aleghezzo/audiopoweramplifier/Latex/graficos-tp1/Corriente.png

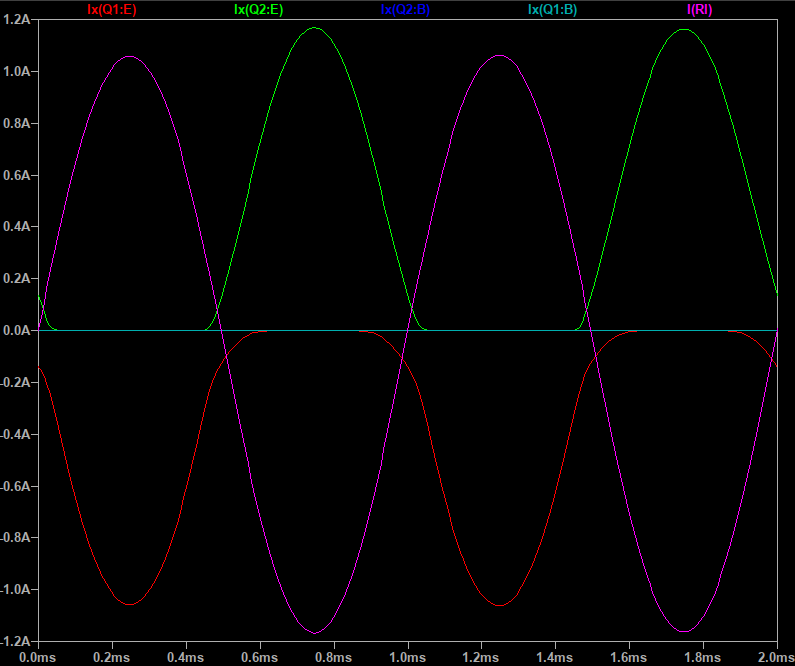
Latex/graficos-tp1/Corriente.png
