aleghezzo/audiopoweramplifier/Latex/graficos-tp1/Dinamico.png

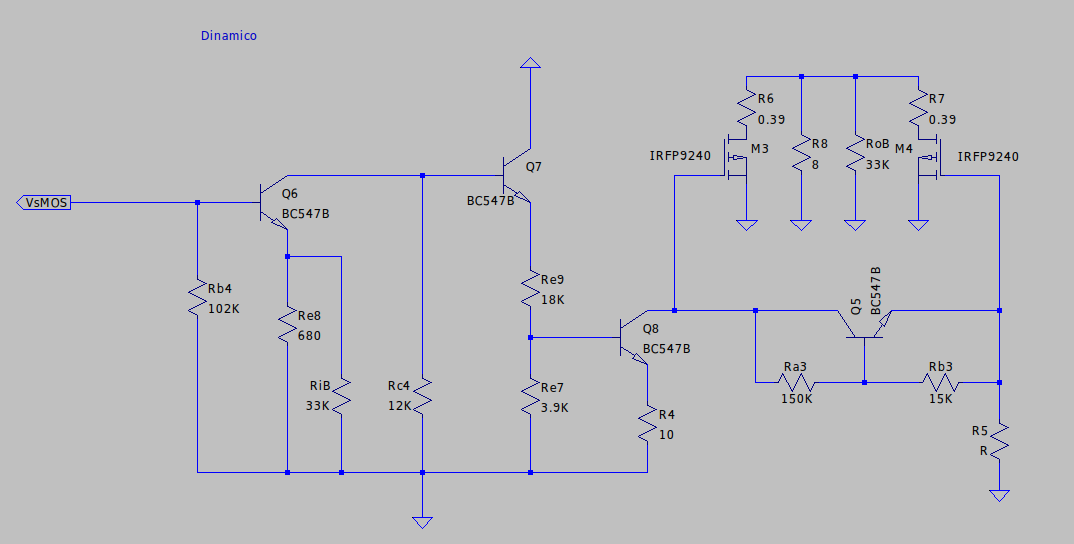
Latex/graficos-tp1/Dinamico.png
