aleghezzo/audiopoweramplifier/Latex/graficos-tp1/DisenoFinalUlt2.png

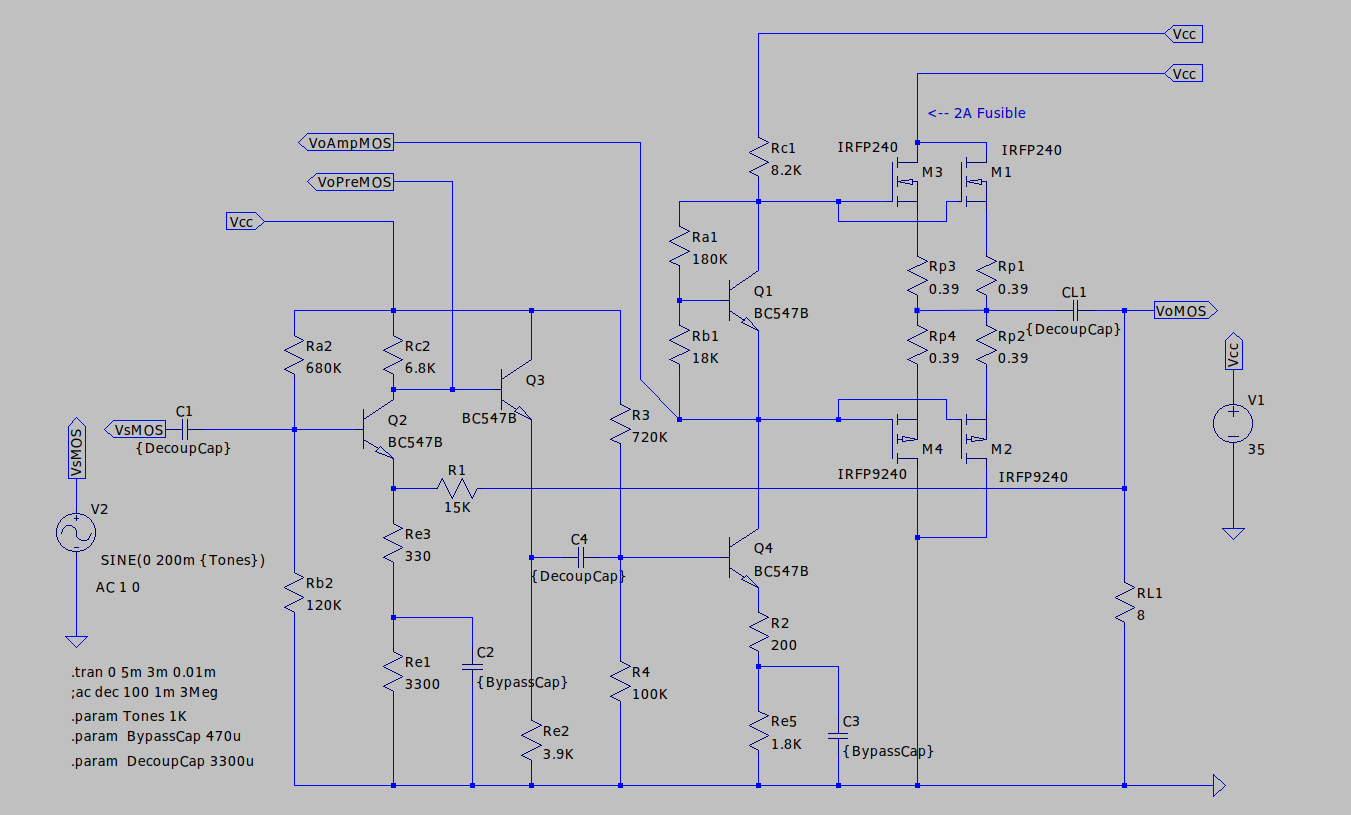
Latex/graficos-tp1/DisenoFinalUlt2.png
