aleghezzo/audiopoweramplifier/Latex/graficos-tp1/EtapaAmplificadoraTBJ.png

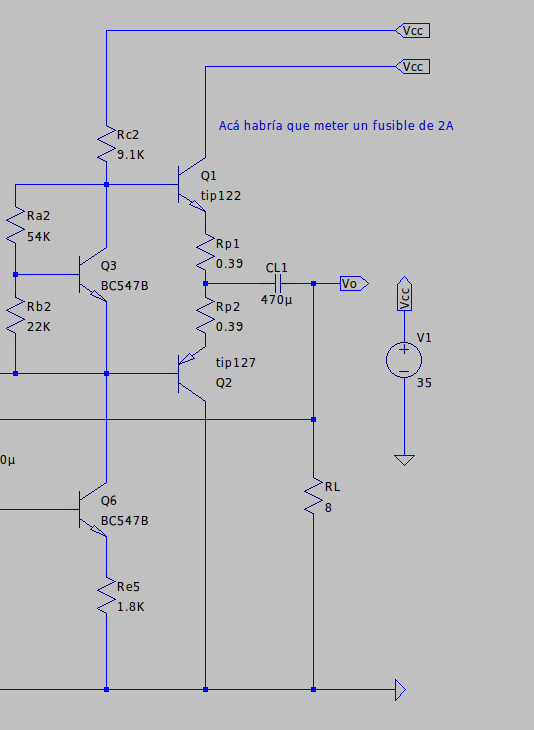
Latex/graficos-tp1/EtapaAmplificadoraTBJ.png
