aleghezzo/audiopoweramplifier/Latex/graficos-tp1/EtapaEntradaTBJ.png

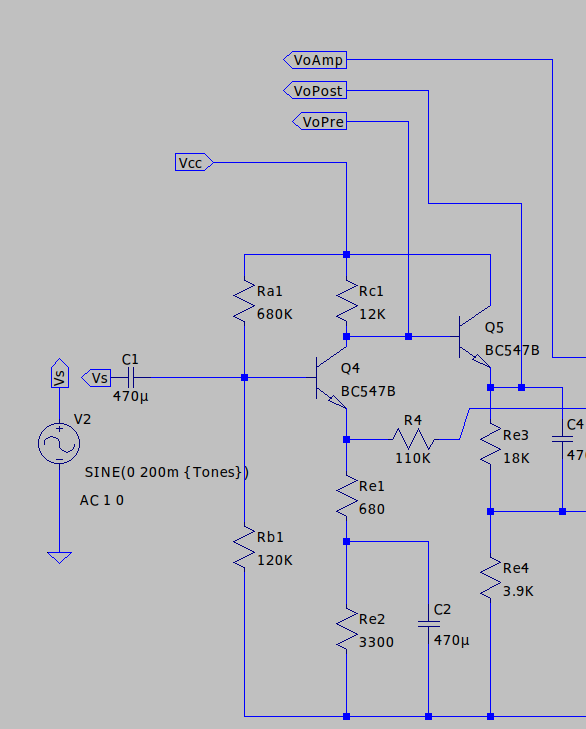
Latex/graficos-tp1/EtapaEntradaTBJ.png
