aleghezzo/audiopoweramplifier/Latex/graficos-tp1/FalsoPNP.png

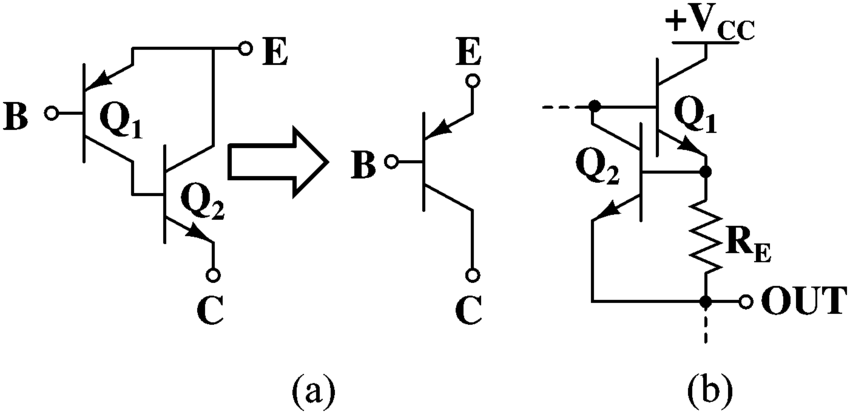
Latex/graficos-tp1/FalsoPNP.png
