aleghezzo/audiopoweramplifier/Latex/graficos-tp1/Potencia.png

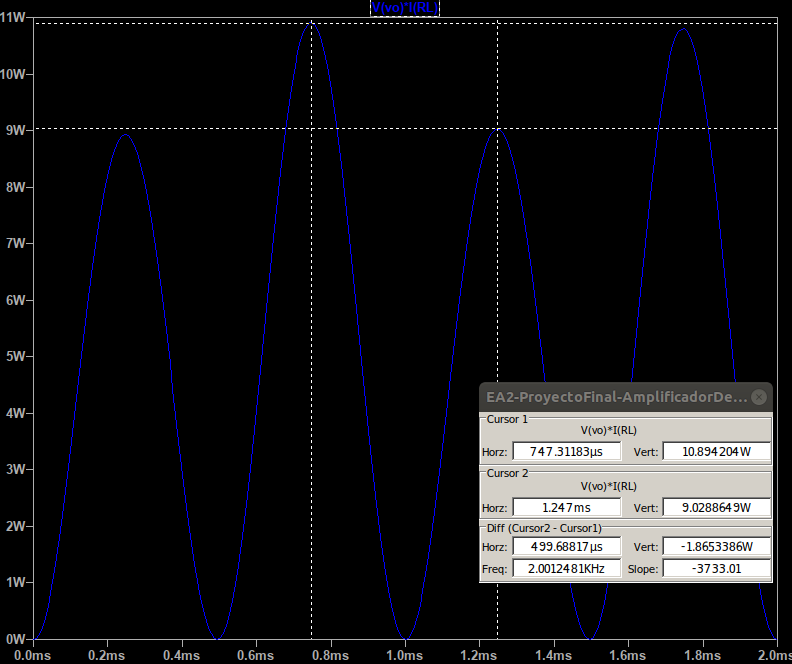
Latex/graficos-tp1/Potencia.png
