aleghezzo/audiopoweramplifier/Latex/graficos-tp1/Vo.png

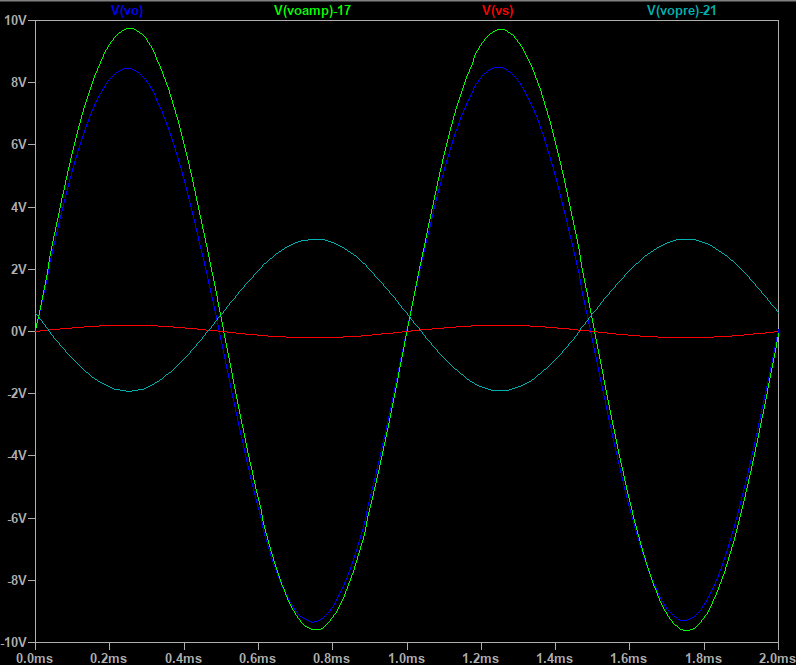
Latex/graficos-tp1/Vo.png
