aleghezzo/audiopoweramplifier/Latex/graficos-tp1/VoAmp.png

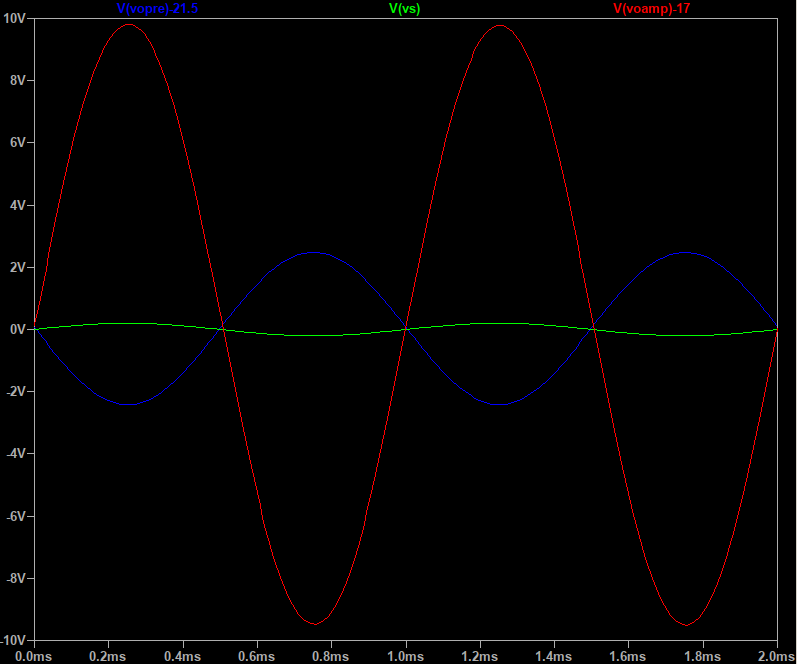
Latex/graficos-tp1/VoAmp.png
