aleghezzo/audiopoweramplifier/Latex/kicad/audioamplifier.pdf

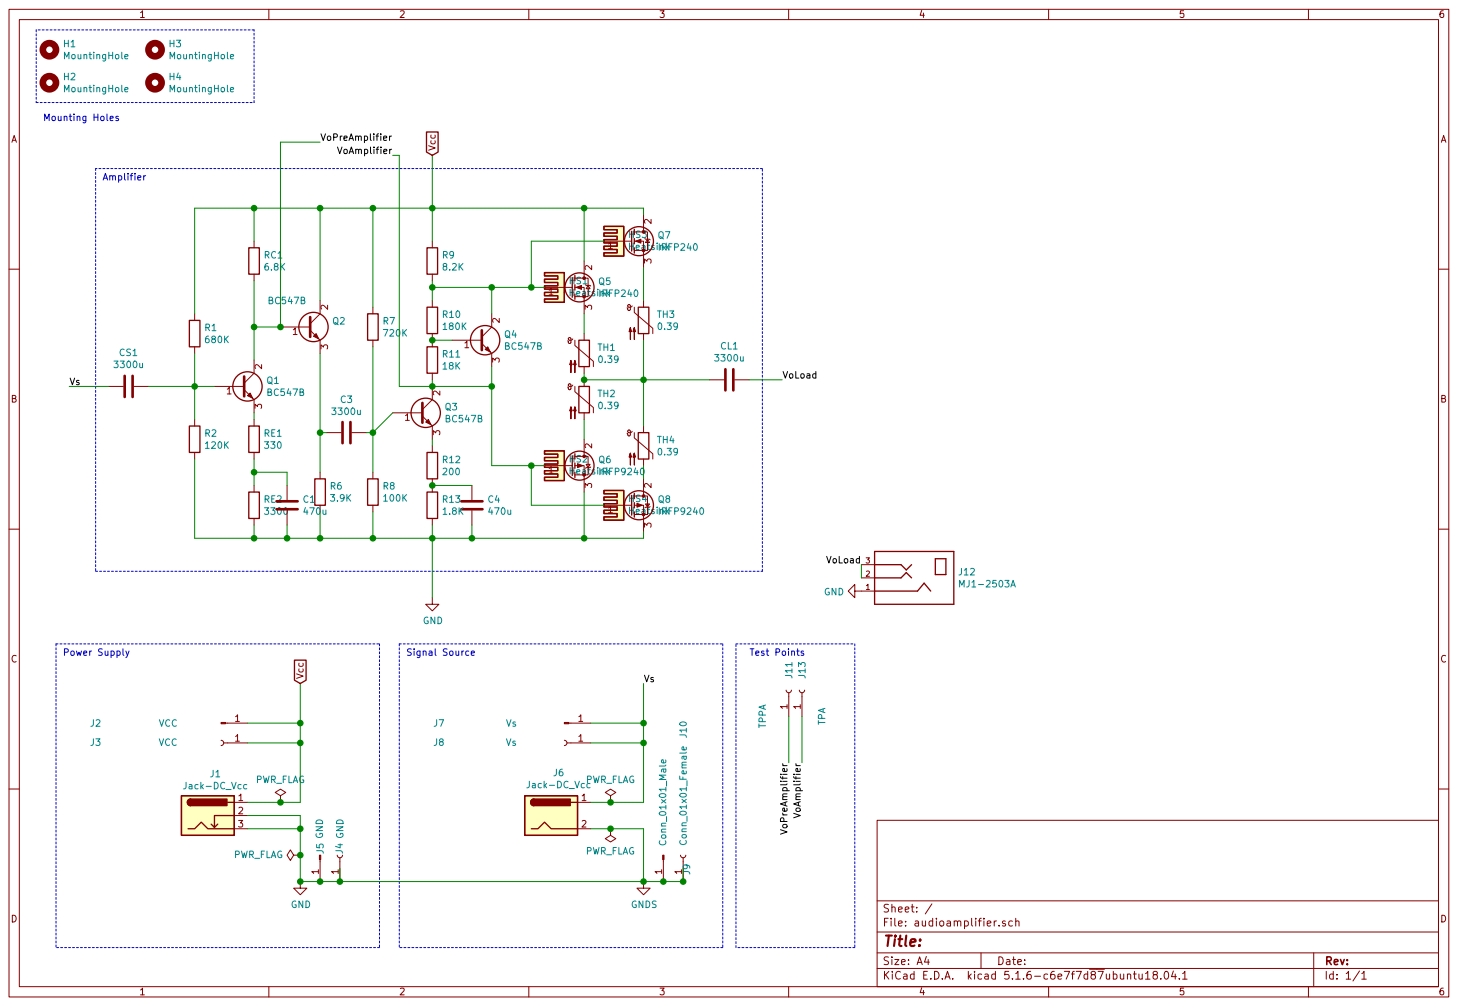
[picture p47: page 1]

HS4 Heatsink HS3 Heatsink HS2 Heatsink HS1 Heatsink

File: audioamplifier.sch Sheet: /
Id: 1/1 Title:
