aleghezzo/audiopoweramplifier/Latex/kicad/audioamplifier-B_Cu.pdf

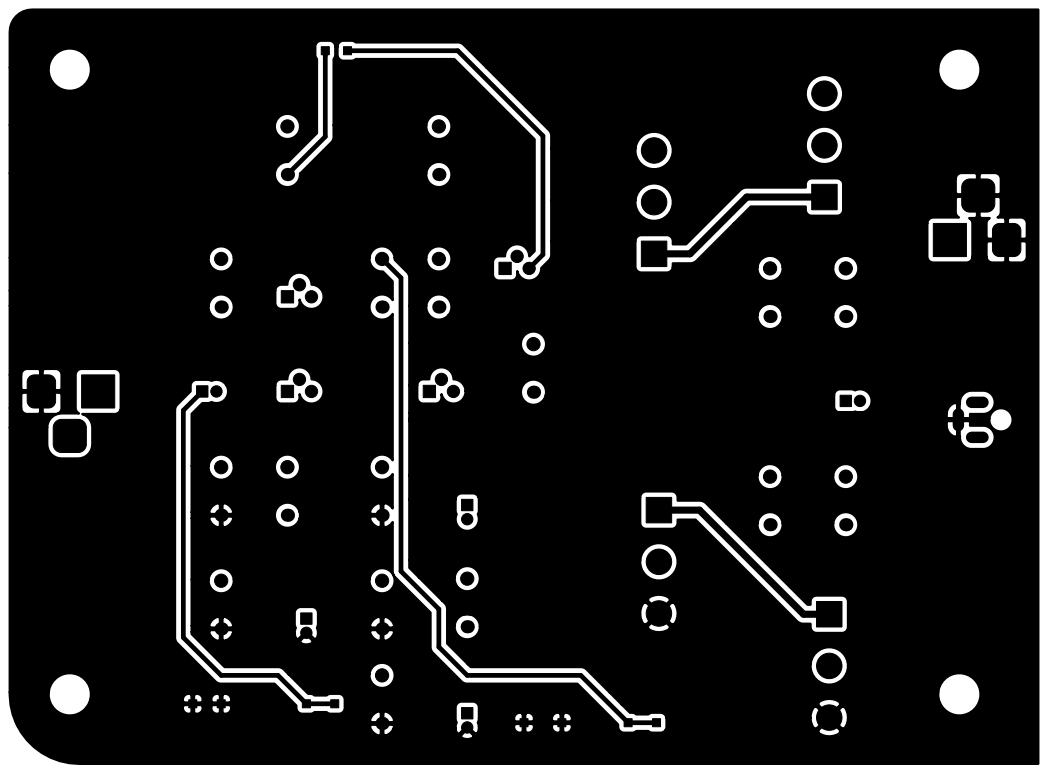
[picture p48: page 1]
