aleghezzo/audiopoweramplifier/Latex/kicad/audioamplifier-B_Mask.pdf

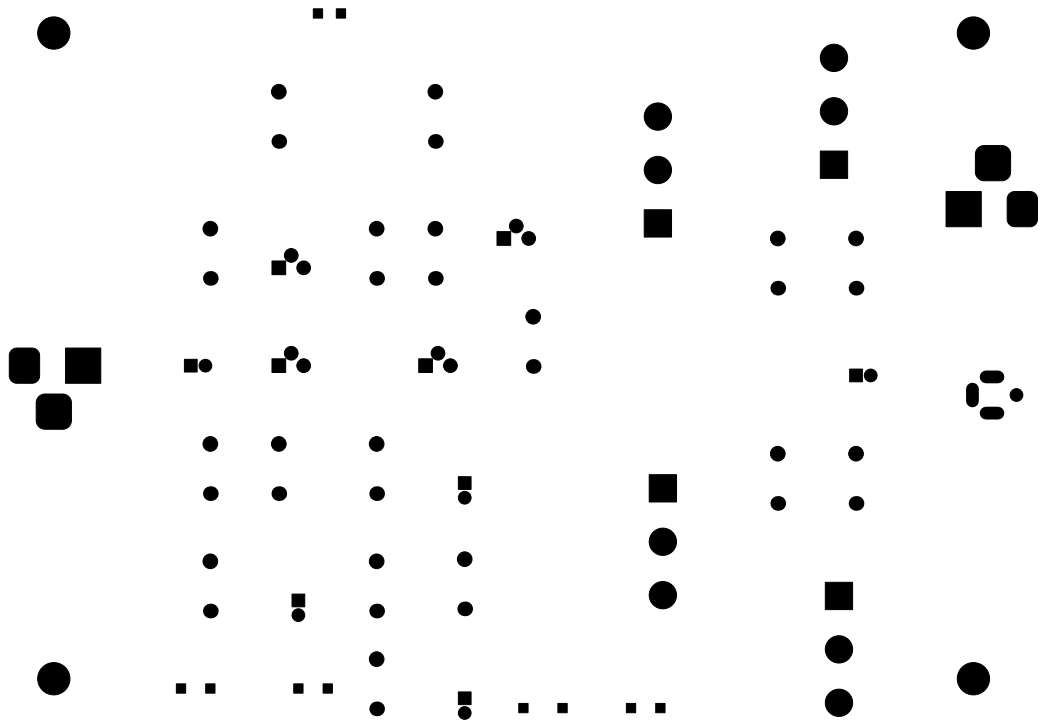
[picture p49: page 1]
