aleghezzo/audiopoweramplifier/Latex/kicad/audioamplifier-Edge_Cuts.pdf

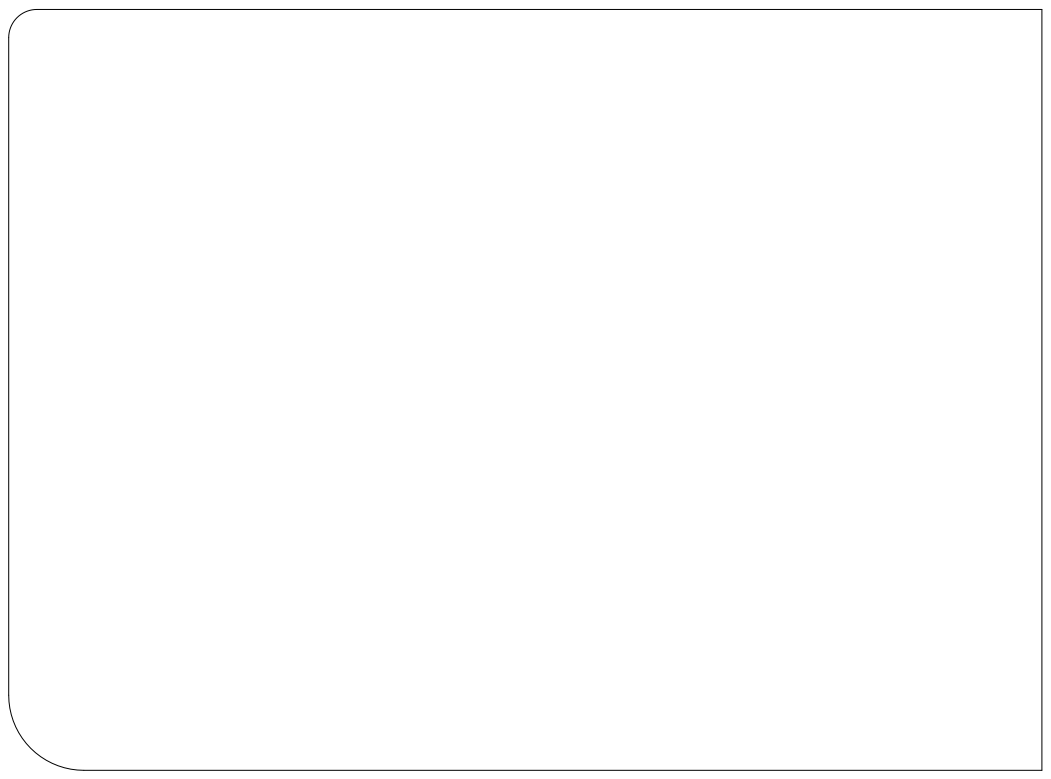
[picture p50: page 1]
