aleghezzo/audiopoweramplifier/Latex/kicad/audioamplifier-F_Cu.pdf

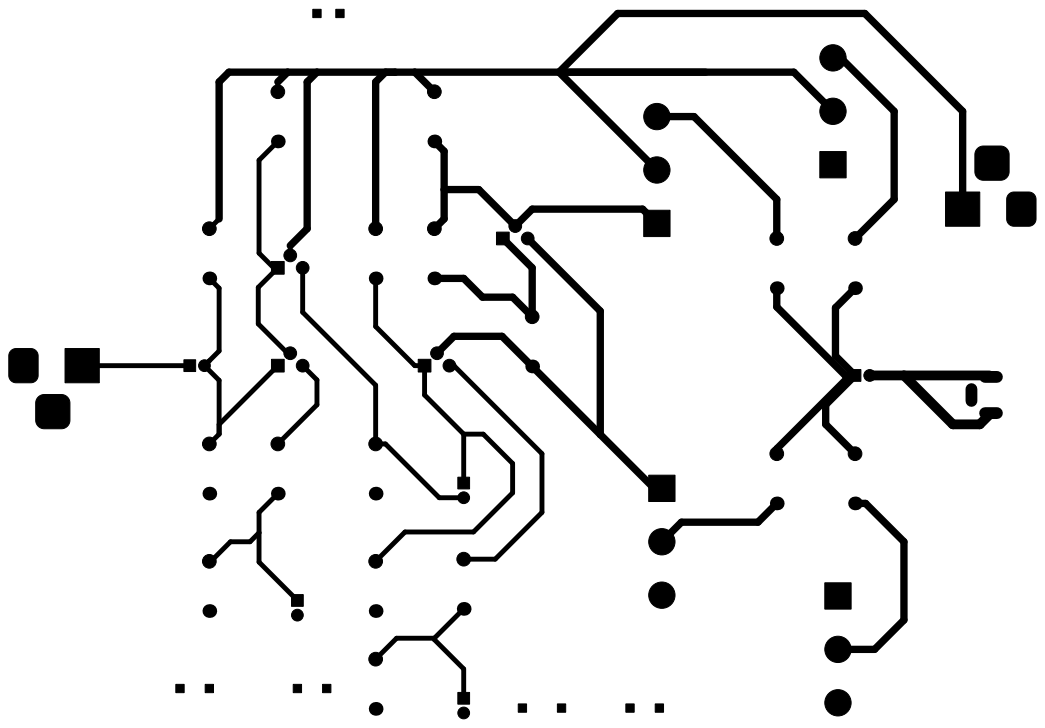
[picture p51: page 1]
