aleghezzo/audiopoweramplifier/Latex/kicad/audioamplifier-F_SilkS.pdf

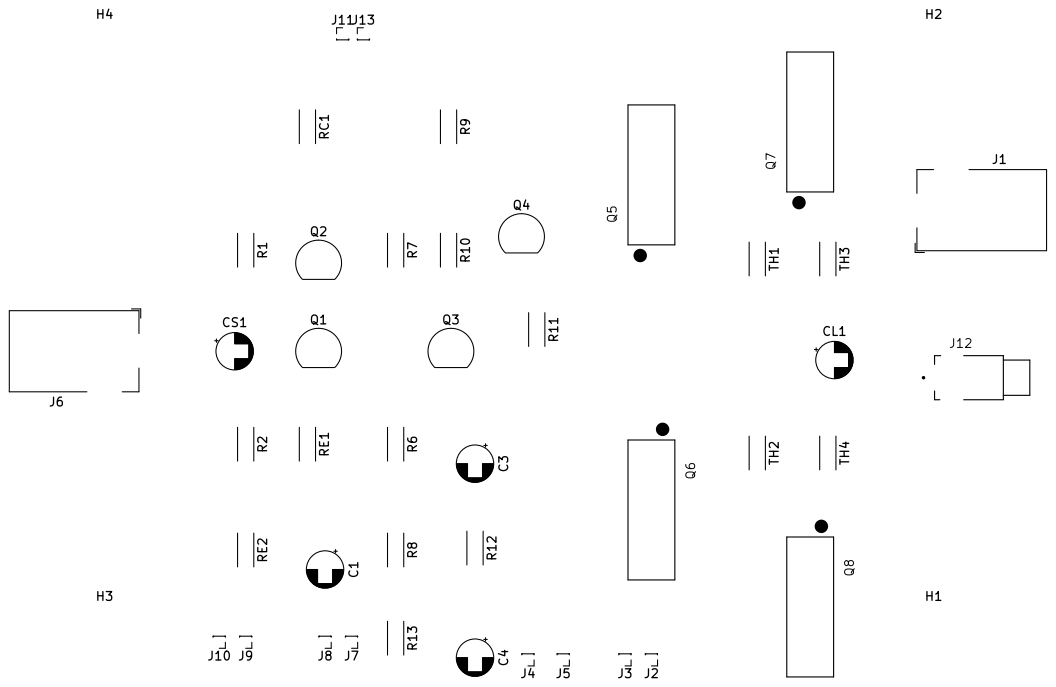
[picture p52: page 1]
