aleghezzo/audiopoweramplifier/Simulación/EA2-ProyectoFinal-AmplificadorDeBajaPotencia_MOS_Only_27-12-2020.asc

C1: cap; {DecoupCap}
C2: cap; {BypassCap}
C3: cap; {BypassCap}
C4: cap; {DecoupCap}
CL1: cap; {DecoupCap}
M1: nmos; IRFP240
M2: pmos; IRFP9240
M3: nmos; IRFP240
M4: pmos; IRFP9240
Q1: npn; BC547B
Q2: npn; BC547B
Q3: npn; BC547B
Q4: npn; BC547B
R1: res; 15K
R2: res; 200
R3: res; 720K
R4: res; 100K
Ra1: res; 180K
Ra2: res; 680K
Rb1: res; 18K
Rb2: res; 120K
Rc1: res; 8.2K
Rc2: res; 6.8K
Re1: res; 3300
Re2: res; 3.9K
Re3: res; 330
Re5: res; 1.8K
RL1: res; 8
Rp1: res; 0.39
Rp2: res; 0.39
Rp3: res; 0.39
Rp4: res; 0.39
V1: voltage; 35
V2: signal; SINE(0 200m {Tones}); AC 1 0
Named nets: 0, Vcc, VoMOS, VoPreMOS, VsMOS, VoAmpMOS
.tran 0 100m 3m 0.01m
;ac dec 100 1m 3Meg
.param Tones 20
<-- 2A Fusible
.param  BypassCap 470u
.param  DecoupCap 3300u
