aleghezzo/audiopoweramplifier/Simulación/EA2-ProyectoFinal-AmplificadorDeBajaPotencia_TBJ_Only.asc

C2: cap; {BypassCap}
C3: cap; {BypassCap}
C4: cap; {DecoupCap}
C5: cap; {DecoupCap}
CL1: cap; {DecoupCap}
Q1: npn; tip122
Q2: pnp; tip127
Q3: npn; BC547B
Q4: npn; BC547B
Q5: npn; BC547B
Q6: npn; BC547B
Q7: npn; tip122
Q8: pnp; tip127
R1: res; 15K
R2: res; 10
R3: res; 720K
R4: res; 100K
Ra1: res; 64K
Ra2: res; 680K
Rb1: res; 33K
Rb2: res; 120K
Rc1: res; 8.2K
Rc2: res; 6.8K
Re1: res; 3300
Re2: res; 3.9K
Re3: res; 330
Re4: res; 1.8K
RL: res; 8
Rp1: res; 0.39
Rp2: res; 0.39
Rp3: res; 0.39
Rp4: res; 0.39
V1: voltage; 35
V5: signal; SINE(0 200m {Tones}); AC 1 0
Named nets: Vcc, Vo, 0, VsTBJ, VoPreMOS, VoAmpMOS
.INCLUDE "C:\\Program Files\\LTC\\LTspiceXVII\\lib\\sub\\TIP122.LIB"
.INCLUDE "C:\\Program Files\\LTC\\LTspiceXVII\\lib\\sub\\TIP127.LIB"
<-- Fusible 2 A
.tran 0 1 0.5 0.01m
;ac dec 100 1m 3Meg
.param Tones 20
.param  BypassCap 470u
.param  DecoupCap 3300u
