aleghezzo/audiopoweramplifier/KiCAD/audioamplifier/audioamplifier.kicad_pcb

## KiCad design KiCAD/audioamplifier/audioamplifier.kicad_pcb (2021-01-25)

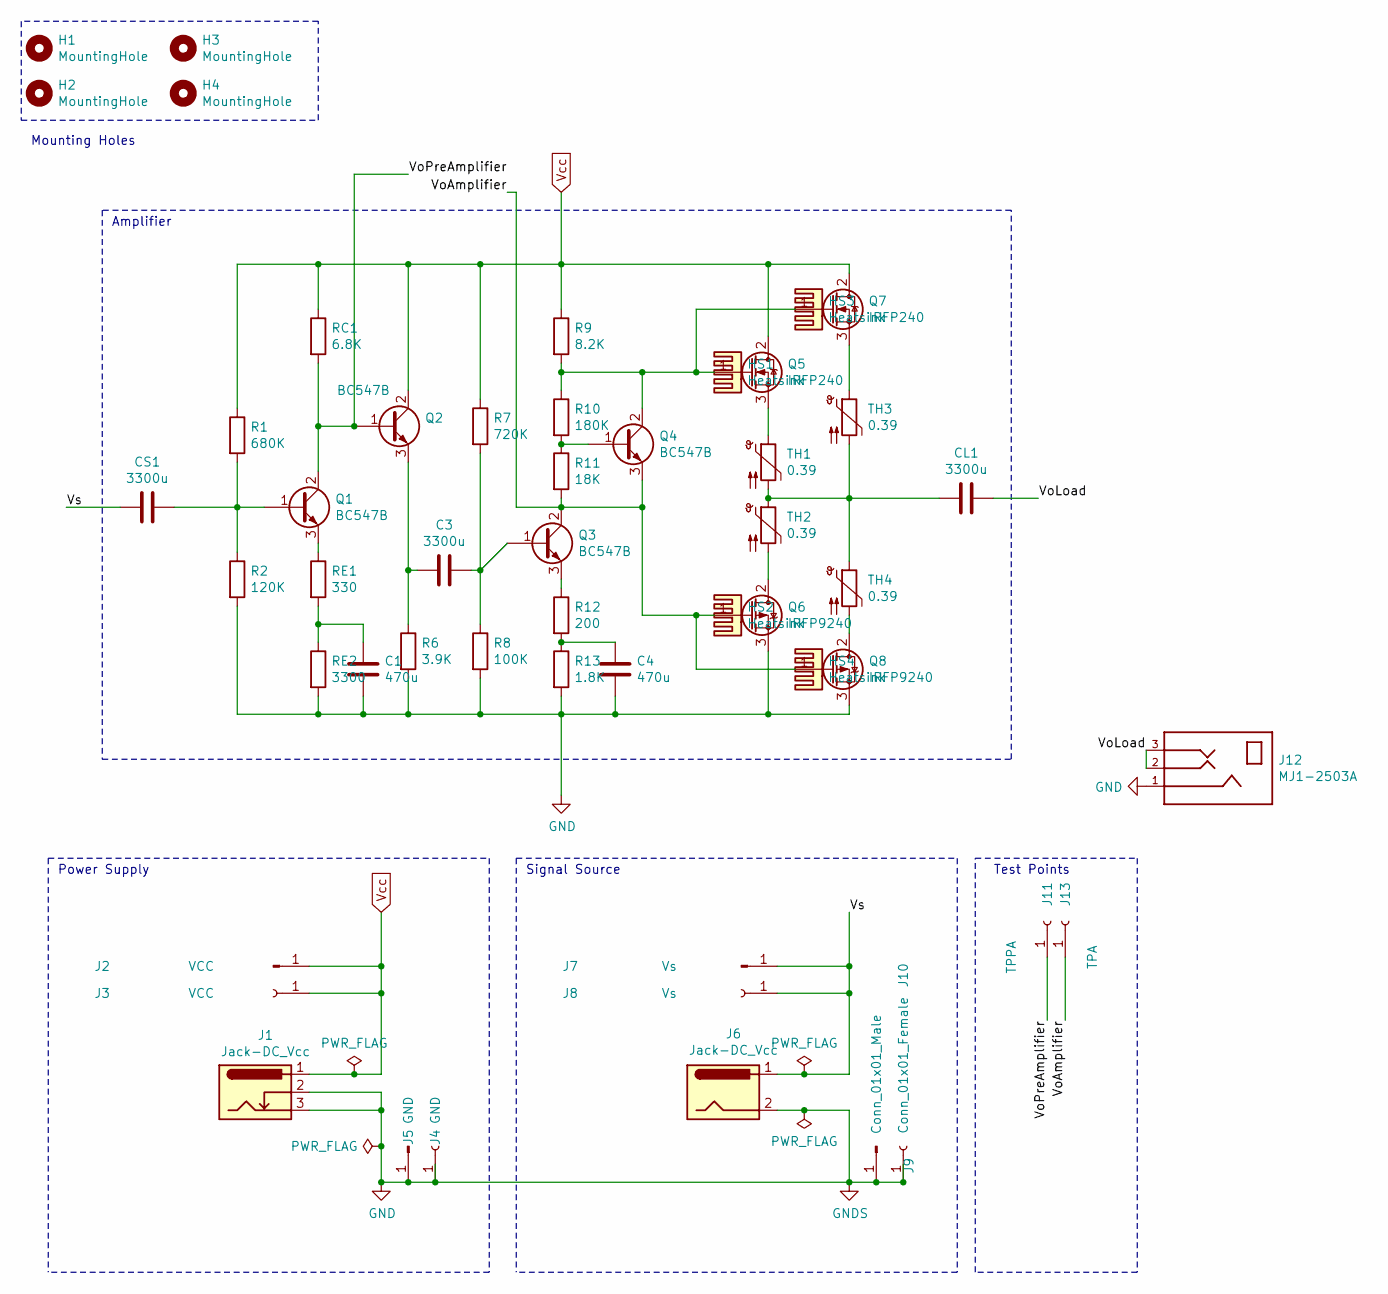
[picture p53: schematic audioamplifier.sch]

Parts:
C1, C4: 470u; CP_Radial_D4.0mm_P1.50mm
C3: 3300u; CP_Radial_D4.0mm_P1.50mm
CL1: 3300u; CP_Radial_D4.0mm_P1.50mm
CS1: 3300u; CP_Radial_D4.0mm_P1.50mm
H1, H2, H3, H4: MountingHole; MountingHole_3.2mm_M3
HS1, HS2, HS3, HS4: Heatsink; Heatsink_Stonecold_HS-132_32x14mm_2xFixation1.5mm
J1, J6: Jack-DC_Vcc; BarrelJack_Horizontal
J2, J3: VCC; PinHeader_1x01_P1.00mm_Vertical
J4, J5: GND; PinHeader_1x01_P1.00mm_Vertical
J7, J8: Vs; PinHeader_1x01_P1.00mm_Vertical
J9: Conn_01x01_Male; PinHeader_1x01_P1.00mm_Vertical
J10: Conn_01x01_Female; PinHeader_1x01_P1.00mm_Vertical
J11: TPPA; PinHeader_1x01_P1.00mm_Vertical
J12: MJ1-2503A; CUI_MJ1-2503A; PART_REV A
J13: TPA; PinHeader_1x01_P1.00mm_Vertical
Q1, Q2, Q3, Q4: BC547B; TO-92
Q5, Q7: IRFP240; TO247AC
Q6, Q8: IRFP9240; TO247AC
R1: 680K; R_Axial_DIN0204_L3.6mm_D1.6mm_P5.08mm_Horizontal
R2: 120K; R_Axial_DIN0204_L3.6mm_D1.6mm_P5.08mm_Horizontal
R6: 3.9K; R_Axial_DIN0204_L3.6mm_D1.6mm_P5.08mm_Horizontal
R7: 720K; R_Axial_DIN0204_L3.6mm_D1.6mm_P5.08mm_Horizontal
R8: 100K; R_Axial_DIN0204_L3.6mm_D1.6mm_P5.08mm_Horizontal
R9: 8.2K; R_Axial_DIN0204_L3.6mm_D1.6mm_P5.08mm_Horizontal
R10: 180K; R_Axial_DIN0204_L3.6mm_D1.6mm_P5.08mm_Horizontal
R11: 18K; R_Axial_DIN0204_L3.6mm_D1.6mm_P5.08mm_Horizontal
R12: 200; R_Axial_DIN0204_L3.6mm_D1.6mm_P5.08mm_Horizontal
R13: 1.8K; R_Axial_DIN0204_L3.6mm_D1.6mm_P5.08mm_Horizontal
RC1: 6.8K; R_Axial_DIN0204_L3.6mm_D1.6mm_P5.08mm_Horizontal
RE1: 330; R_Axial_DIN0204_L3.6mm_D1.6mm_P5.08mm_Horizontal
RE2: 3300; R_Axial_DIN0204_L3.6mm_D1.6mm_P5.08mm_Horizontal
TH1, TH2, TH3, TH4: 0.39; R_Axial_DIN0204_L3.6mm_D1.6mm_P5.08mm_Horizontal

Connections:
/VoAmplifier: J13.1, Q3.2 (C), Q4.3 (E), Q6.1 (G), Q8.1 (G), R11.2
/VoLoad: CL1.2, J12.2, J12.3
/VoPreAmplifier: J11.1, Q1.2 (C), Q2.1 (B), RC1.2
/Vs: CS1.1, J6.1, J7.1, J8.1
GND: C1.2, C4.2, J1.2, J1.3, J4.1, J5.1, J6.2, J9.1, J10.1, J12.1, Q6.3 (S), Q8.3 (S), R2.2, R6.2, R8.2, R13.2, RE2.2
unnamed: C1.1, RE1.2, RE2.1
unnamed: C3.1, Q3.1 (B), R7.2, R8.1
unnamed: C3.2, Q2.3 (E), R6.1
unnamed: C4.1, R12.2, R13.1
unnamed: CL1.1, TH1.2, TH2.1, TH3.2, TH4.1
unnamed: CS1.2, Q1.1 (B), R1.2, R2.1
unnamed: Q1.3 (E), RE1.1
unnamed: Q3.3 (E), R12.1
unnamed: Q4.1 (B), R10.2, R11.1
unnamed: Q4.2 (C), Q5.1 (G), Q7.1 (G), R9.2, R10.1
unnamed: Q5.3 (S), TH1.1
unnamed: Q6.2 (D), TH2.2
unnamed: Q7.3 (S), TH3.1
unnamed: Q8.2 (D), TH4.2
Vcc: J1.1, J2.1, J3.1, Q2.2 (C), Q5.2 (D), Q7.2 (D), R1.1, R7.1, R9.1, RC1.1

Notes on the sheet:
Power Supply
Signal Source
Test Points
Mounting Holes
Amplifier

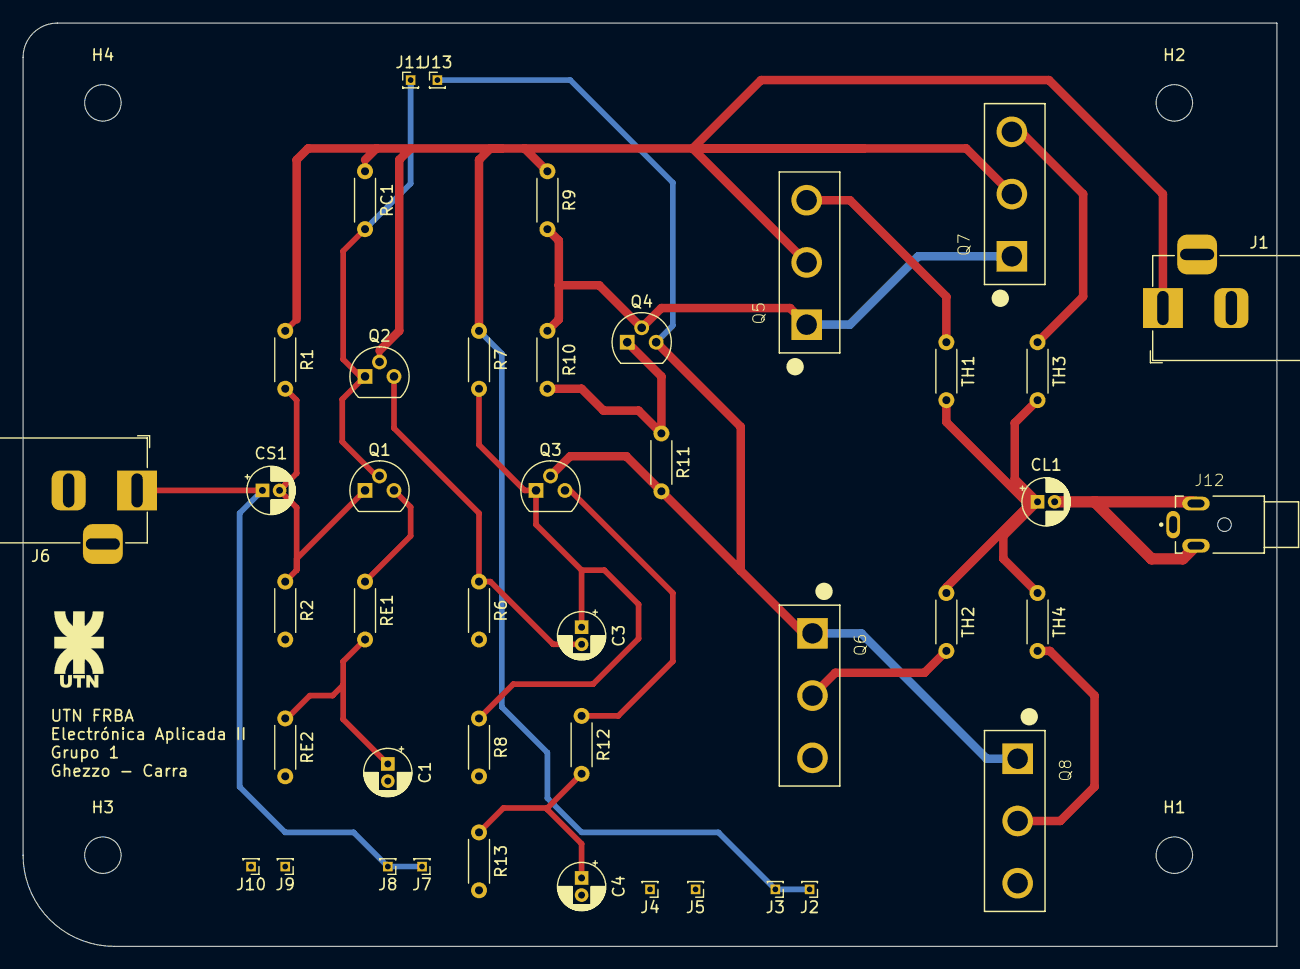
[picture p54: board audioamplifier.kicad_pcb from above]

Board: 2 copper layers, 110.0 x 81.0 mm, 47 parts (0 on the bottom side), 20 nets.
